Wizard-s-Chess/Wizards-Chess/Main Firmware/chess.jpg

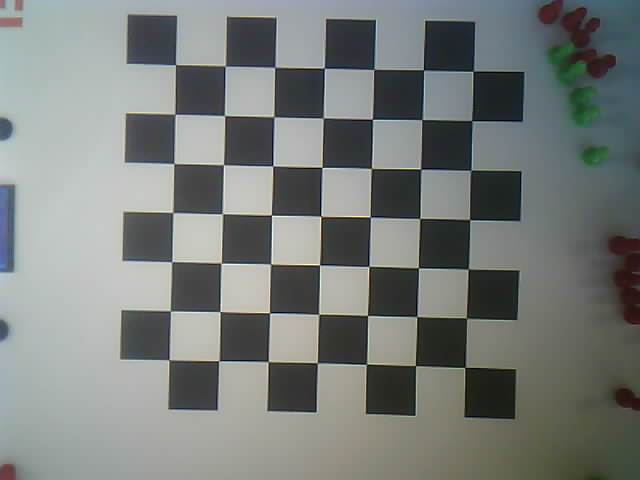
Main Firmware/chess.jpg
