Wizard-s-Chess/Wizards-Chess/Main Firmware/current.jpg

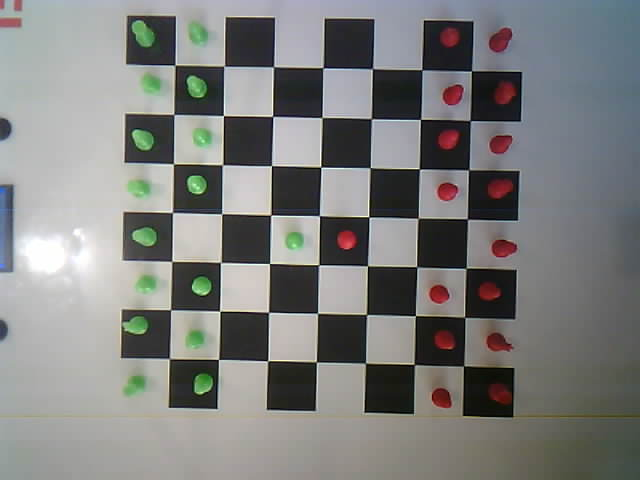
Main Firmware/current.jpg
