Wizard-s-Chess/Wizards-Chess/Main Firmware/empty1.jpg

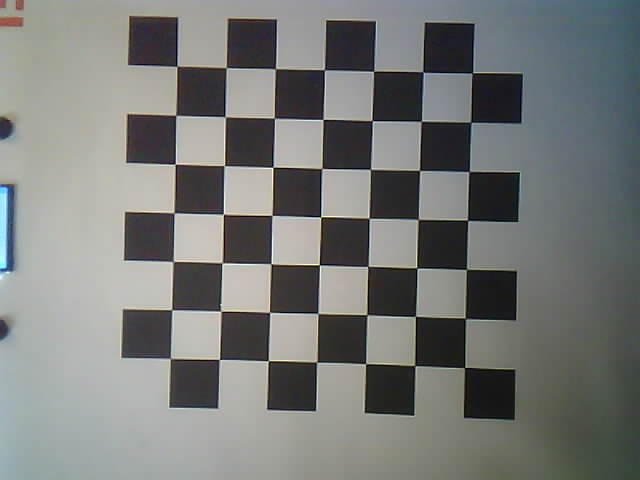
Main Firmware/empty1.jpg
