Wizard-s-Chess/Wizards-Chess/pictures/gen_work3.PNG

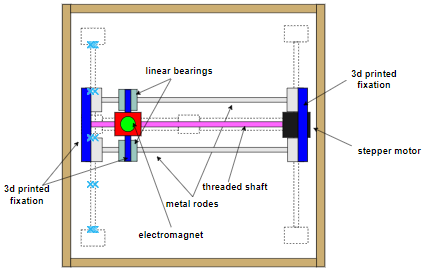
pictures/gen_work3.PNG
