Wizard-s-Chess/Wizards-Chess/pictures/insert_bearing1.PNG

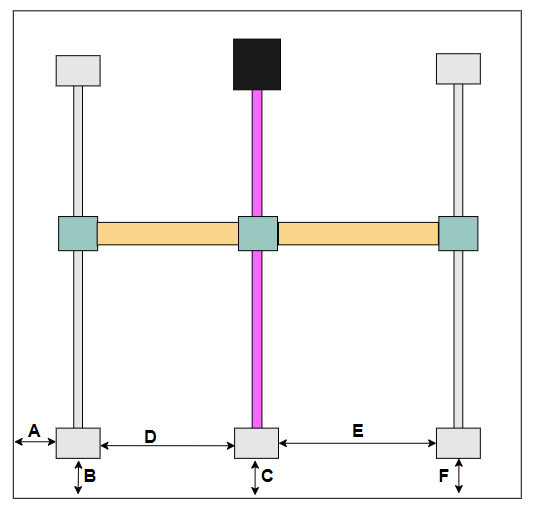
pictures/insert_bearing1.PNG
