Wizard-s-Chess/Wizards-Chess/Main Firmware/Tests CV2/-.jpg

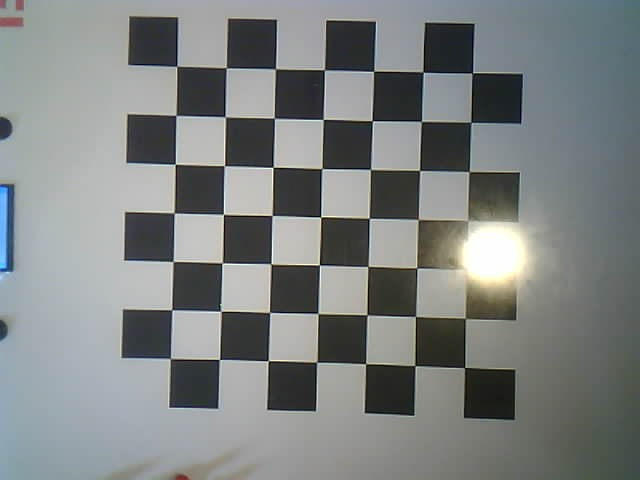
Main Firmware/Tests CV2/-.jpg
