Wizard-s-Chess/Wizards-Chess/Main Firmware/Tests CV2/_empty.jpg

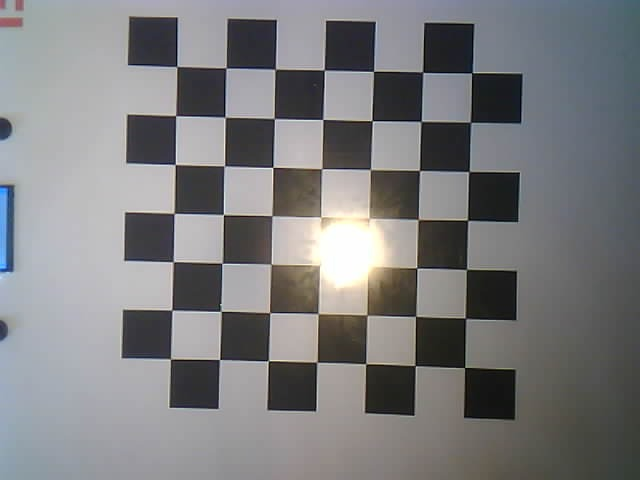
Main Firmware/Tests CV2/_empty.jpg
