Wizard-s-Chess/Wizards-Chess/Main Firmware/Tests CV2/Board Captures/20221009104345.jpg

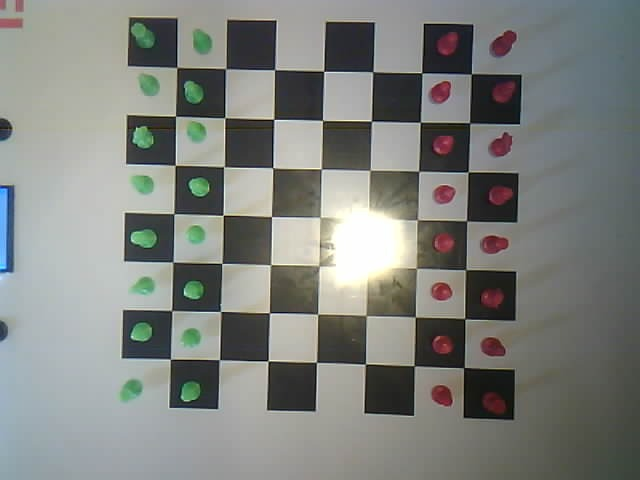
Main Firmware/Tests CV2/Board Captures/20221009104345.jpg
