Wizard-s-Chess/Wizards-Chess/Main Firmware/Tests CV2/test/20221011132257.jpg

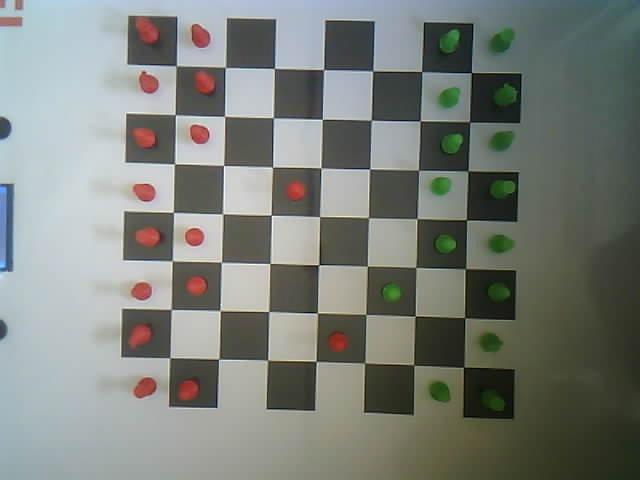
Main Firmware/Tests CV2/test/20221011132257.jpg
