Wizard-s-Chess/Wizards-Chess/Main Firmware/Tests CV2/test/20221011132342.jpg

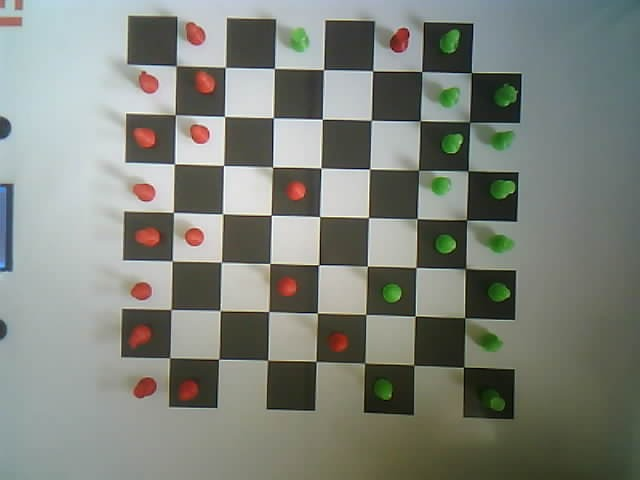
Main Firmware/Tests CV2/test/20221011132342.jpg
