Wizard-s-Chess/Wizards-Chess/Main Firmware/Tests CV2/test/d/20221009123827.jpg

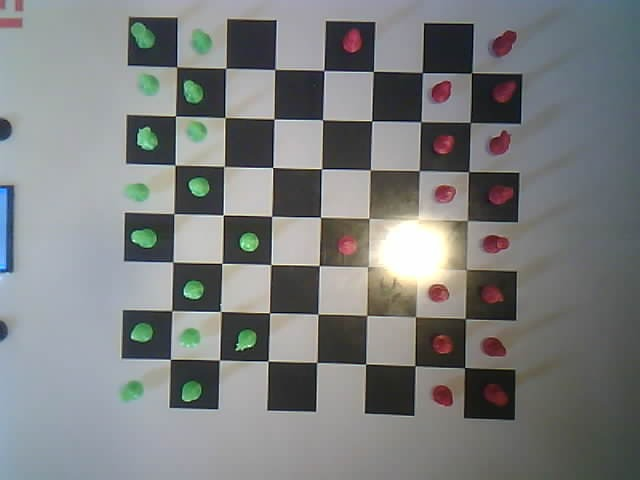
Main Firmware/Tests CV2/test/d/20221009123827.jpg
