Wizard-s-Chess/Wizards-Chess/Main Firmware/Tests CV2/test/seq2/20221009131352.jpg

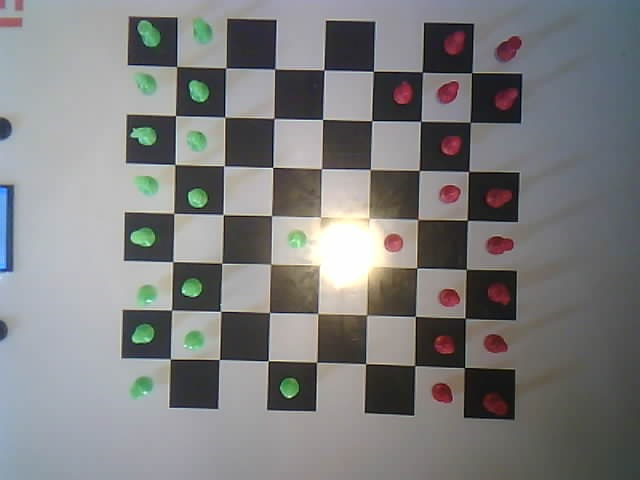
Main Firmware/Tests CV2/test/seq2/20221009131352.jpg
