Wizard-s-Chess/Wizards-Chess/Main Firmware/Tests CV2/test/seq2/20221009132510.jpg

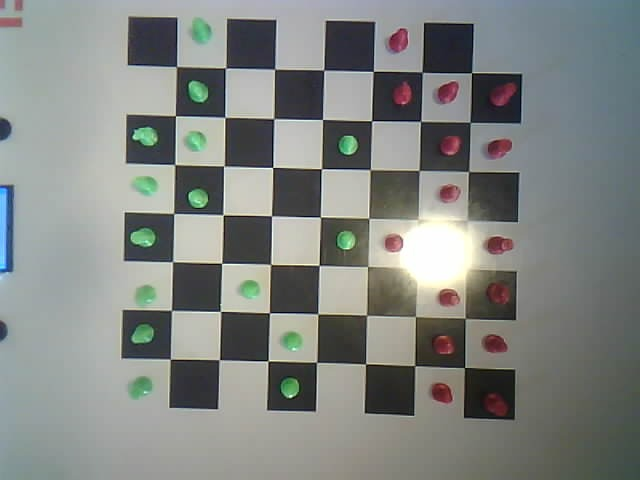
Main Firmware/Tests CV2/test/seq2/20221009132510.jpg
