Wizard-s-Chess/Wizards-Chess/Main Firmware/Tests CV2/test/seq3 (neg)/20221009133454.jpg

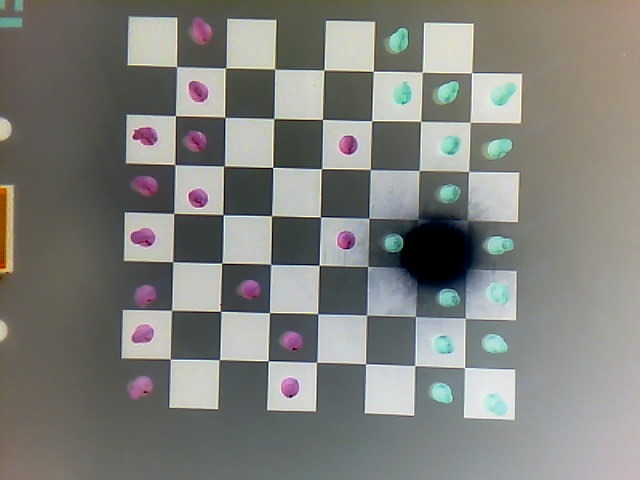
Main Firmware/Tests CV2/test/seq3 (neg)/20221009133454.jpg
