Wizard-s-Chess/Wizards-Chess/Main Firmware/Tests CV2/test/seq4/20221009213334.jpg

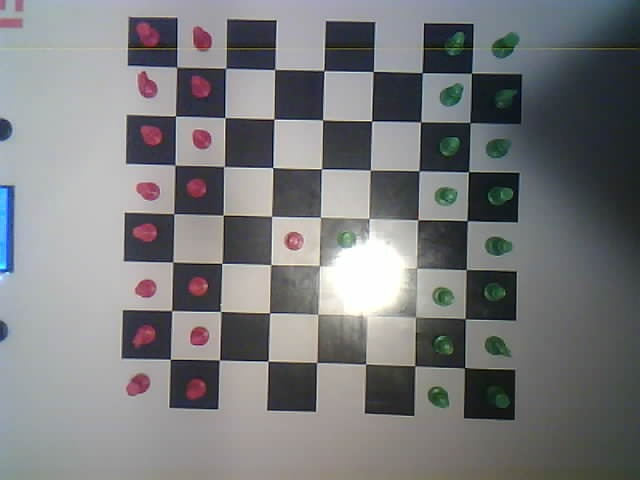
Main Firmware/Tests CV2/test/seq4/20221009213334.jpg
