Wizard-s-Chess/Wizards-Chess/Main Firmware/Buttons.py

if not __debug__:
    import RPi.GPIO as GPIO
import time


def buttons_init():
    print(__debug__)
    if not __debug__:
        GPIO.setwarnings(False)
        GPIO.setmode(GPIO.BCM)
        GPIO.setup(22, GPIO.IN, pull_up_down=GPIO.PUD_UP)
        GPIO.setup(27, GPIO.IN, pull_up_down=GPIO.PUD_UP)


def button_pressed():
    if not __debug__:
        v1 = GPIO.input(22)
        v2 = GPIO.input(27)
        return [v1 == 0, v2 == 0]
    a = input("input:")
    return [len(a) > 0, not (len(a) > 0)]
