Wizard-s-Chess/Wizards-Chess/(commit log)

2022-05-09 adding the stepper motor test code
2022-05-09 add arduino to main
2022-05-11 esp32.ino added
2022-05-12 creation of motors folder to open in arduino
2022-05-12 little changes during calibration
2022-05-12 change motor speed
2022-05-12 motors new speed reconfig
2022-05-12 add magnet activ to python function
2022-05-12 bug motors
2022-05-16 calibrate the CV range for red and green
2022-05-17 add button code
2022-05-17 button working
2022-05-19 Added reordered code, with the almost complete code for the raspberry pi
    -The Main Firmware folder contains the supposedly final versions of the programs for the raspberry pi. I reoredered the placing of the different modules.
    -Movements of the motor are supposedly ready
    There's also an AI vs AI mode
2022-05-29 added magnet deactivation
2022-05-29 CV calibrated
2022-05-29 adapted computer vision for raspberry
2022-05-30 fix the CV with lower resolution (VGA for the res)
    [ChessAI.py, ComputerVision.py]
2022-05-31 correct diff between boards
    [ComputerVision.py]
2022-10-12 half baked revision of the CV to detect piece moves
    trying a new approach on how to detect player moves via the camera
2022-11-12 tweaks in the CV and adapting to the board
